nuclearfurnace/cec-wifi-bridge/README.md

# cec-wifi-bridge
A WiFi-enabled HDMI dongle for issuing CEC commands.
