nuclearfurnace/cec-wifi-bridge/projects/enclosure/cec-wifi-bridge-board-rev-a.SLDASM

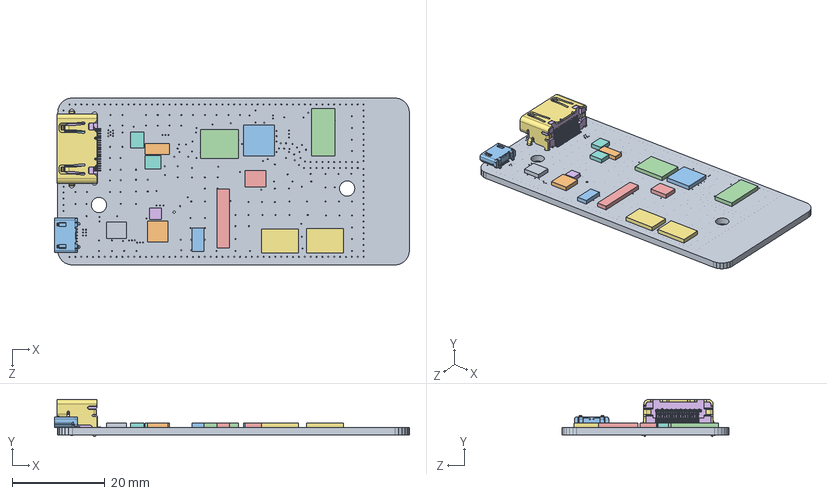
[picture p1: CAD file, 2017-03-05]
projects/enclosure/cec-wifi-bridge-board-rev-a.SLDASM
76.6 x 8.00 x 36.1 mm
cecwifibridgereva
SOD123_1N4148
1X02_J2_1X02
2X04_DEBUG
1X05_PROGRAM
COILCRAFTXPL2010_2_2UH
ALPSSKQG_RESET x 2
SC70_MMBT3904 x 2
5SOT23_MCP73831_2_OT
SPVSONN10DRC_TPS61200DRC
ESP8266EX_ESP8266EX
SOIC8_SPIFLASHSOIC8
EPSONTSX3225_26MHZ
10029451_001_ASM
10029452-001_FLAT
10029452-001_FLAT_1
10029452-001_FLAT_2
10029452-001_FLAT_3
10029452-001_FLAT_4
10029452-001_FLAT_5
10029452-001_FLAT_6
10029452-001_FLAT_7
10029452-001_FLAT_8
10029452-001_FLAT_9
10029452-002_FLAT
10029452-002_FLAT_1
10029452-002_FLAT_2
10029452-002_FLAT_3
10029452-002_FLAT_4
10029452-002_FLAT_5
10029452-002_FLAT_6
10029452-002_FLAT_7
10029452-002_FLAT_8
DX4R005H
