nuclearfurnace/cec-wifi-bridge/projects/enclosure/enclosure-top.sldprt

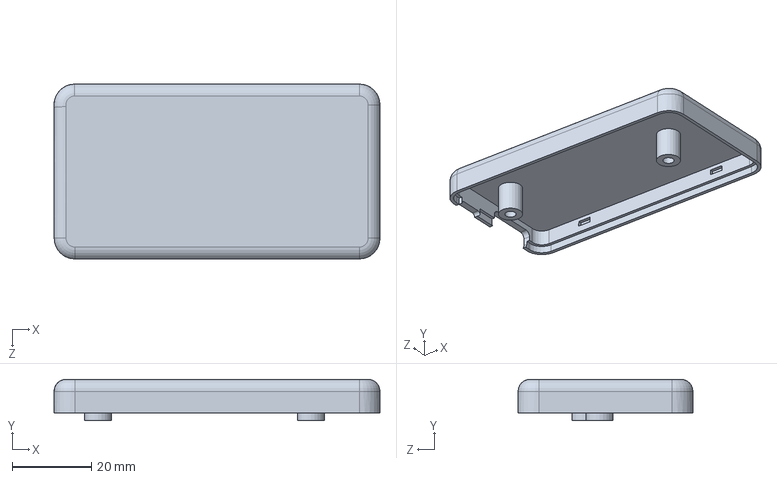
[picture p3: CAD file, 2017-03-05]
projects/enclosure/enclosure-top.sldprt
82.0 x 10.4 x 44.0 mm
