nuclearfurnace/cec-wifi-bridge/projects/enclosure/enclosure-bottom.sldprt

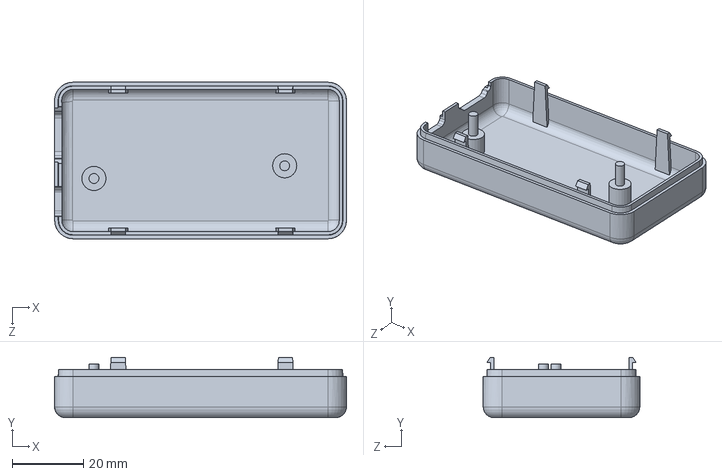
[picture p4: CAD file, 2017-03-05]
projects/enclosure/enclosure-bottom.sldprt
82.0 x 16.9 x 44.0 mm
