nuclearfurnace/cec-wifi-bridge/projects/enclosure/components/DX4R005H.SLDPRT

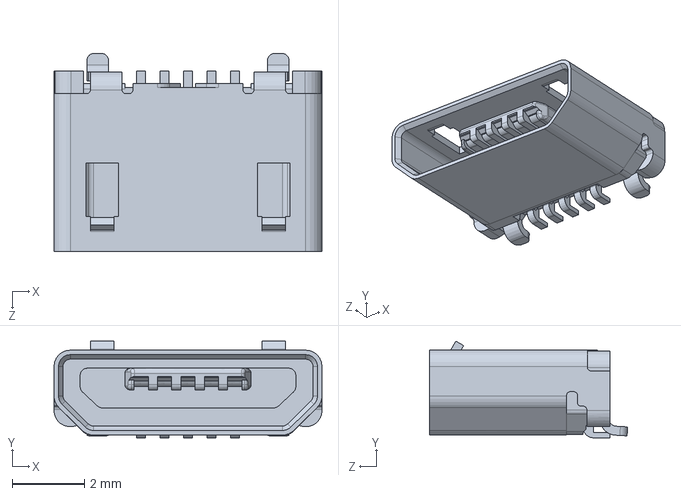
[picture p5: CAD file, 2017-03-05]
projects/enclosure/components/DX4R005H.SLDPRT
7.42 x 2.68 x 5.49 mm
