nuclearfurnace/cec-wifi-bridge/projects/enclosure/components/10029449-001LF.SLDASM

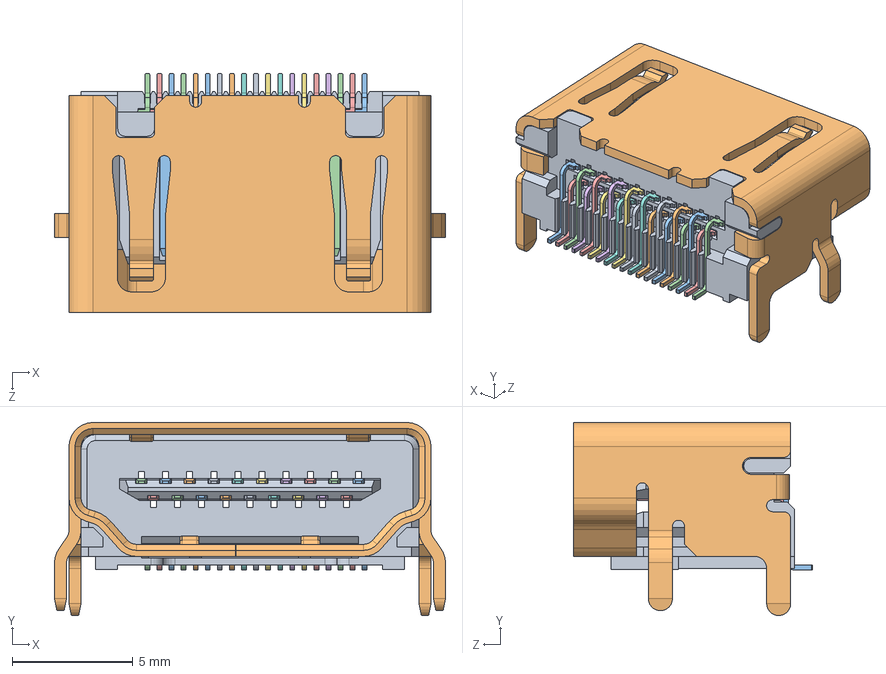
[picture p6: CAD file, 2017-03-05]
projects/enclosure/components/10029449-001LF.SLDASM
16.2 x 8.00 x 9.90 mm
10029451_001_ASM
10029452-001_FLAT
10029452-001_FLAT_1
10029452-001_FLAT_2
10029452-001_FLAT_3
10029452-001_FLAT_4
10029452-001_FLAT_5
10029452-001_FLAT_6
10029452-001_FLAT_7
10029452-001_FLAT_8
10029452-001_FLAT_9
10029452-002_FLAT
10029452-002_FLAT_1
10029452-002_FLAT_2
10029452-002_FLAT_3
10029452-002_FLAT_4
10029452-002_FLAT_5
10029452-002_FLAT_6
10029452-002_FLAT_7
10029452-002_FLAT_8
