nuclearfurnace/cec-wifi-bridge/(list of files, cad)

Other CAD files:
projects/enclosure/components/10029451_001_ASM.sldprt
projects/enclosure/components/10029452-001_FLAT_5.sldprt
projects/enclosure/components/10029452-002_FLAT_7.sldprt
projects/enclosure/components/10029452-001_FLAT_9.sldprt
projects/enclosure/components/10029452-002_FLAT.sldprt
projects/enclosure/components/10029452-001_FLAT.sldprt
projects/enclosure/components/10029452-001_FLAT_2.sldprt
projects/enclosure/components/10029452-002_FLAT_3.sldprt
projects/enclosure/components/10029452-001_FLAT_3.sldprt
projects/enclosure/components/10029452-002_FLAT_8.sldprt
projects/enclosure/components/10029452-002_FLAT_5.sldprt
projects/enclosure/components/10029452-002_FLAT_1.sldprt
projects/enclosure/3d/enclosure-bottom.STL
projects/enclosure/3d/enclosure-top.STL
projects/enclosure/components/10029450.sldprt
projects/enclosure/components/10029452-001_FLAT_1.sldprt
projects/enclosure/components/10029452-001_FLAT_4.sldprt
projects/enclosure/components/10029452-001_FLAT_6.sldprt
projects/enclosure/components/10029452-001_FLAT_7.sldprt
projects/enclosure/components/10029452-001_FLAT_8.sldprt
projects/enclosure/components/10029452-002_FLAT_2.sldprt
projects/enclosure/components/10029452-002_FLAT_4.sldprt
projects/enclosure/components/10029452-002_FLAT_6.sldprt
projects/enclosure/enclosure.SLDPRT
