nuclearfurnace/cec-wifi-bridge/projects/cec-wifi-bridge-rev-a/cec-wifi-bridge-rev-a.brd

## EAGLE design projects/cec-wifi-bridge-rev-a/cec-wifi-bridge-rev-a.brd (2017-03-27)

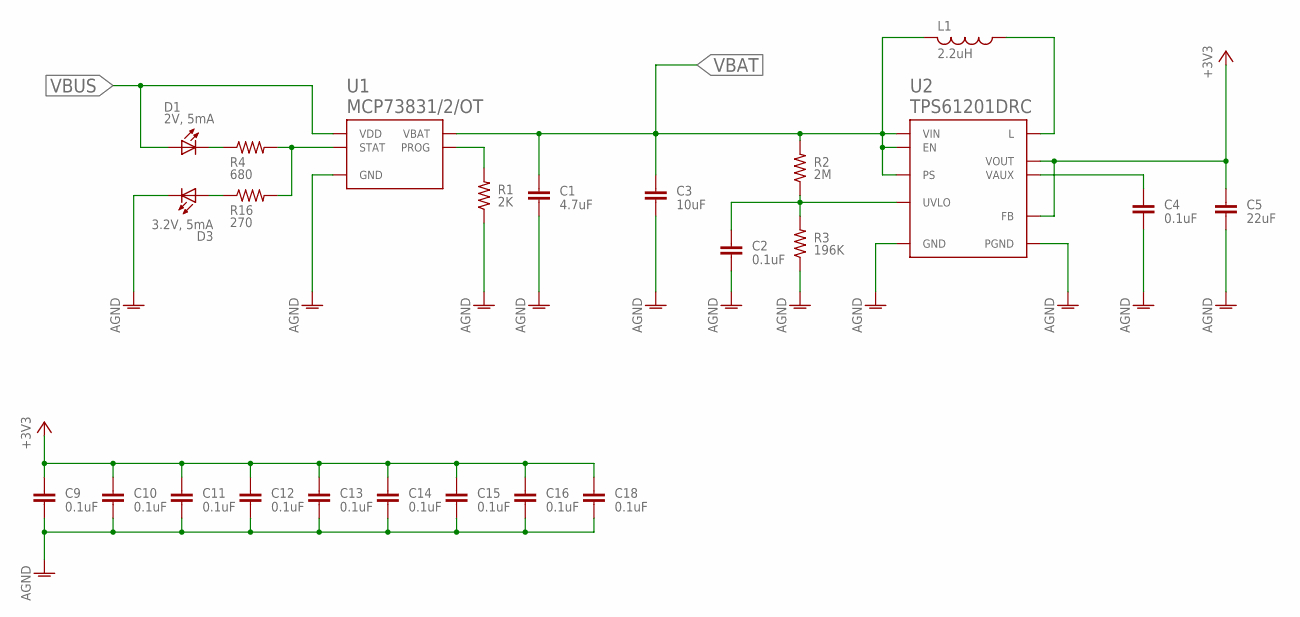
[picture p7: schematic cec-wifi-bridge-rev-a.sch, sheet 1]

Parts:
C1: 4.7uF; C0603
C2, C4, C9, C10, C11, C12, C13, C14, C15, C16, C18: 0.1uF; C0402
C3: 10uF; C0805
C5: 22uF; C0805
D1: 2V, 5mA; DIALIGHT-0603
D3: 3.2V, 5mA; DIALIGHT-0603
L1: 2.2uH; COILCRAFT-XPL2010
R1: 2K; R0402
R2: 2M; R0402
R3: 196K; R0402
R4: 680; R0603
R16: 270; R0603
U1: MCP73831/2/OT; 5-SOT23
U2: TPS61201DRC; S-PVSON-N10-DRC

Connections:
+3V3: C5.1, C9.1, C10.1, C11.1, C12.1, C13.1, C14.1, C15.1, C16.1, C18.1, U2.P$2 (VOUT), U2.P$10 (FB); also elsewhere on the board
AGND: C1.2, C2.2, C3.2, C4.2, C5.2, C9.2, C10.2, C11.2, C12.2, C13.2, C14.2, C15.2, C16.2, C18.2, D3.2 (C), R1.1, R3.1, U1.2 (GND), U2.GND-VIA-1 (PGND), U2.GND-VIA-2 (PGND), U2.GND-VIA-3 (PGND), U2.GND-VIA-4 (PGND), U2.GND-VIA-5 (PGND), U2.P$4 (PGND), U2.P$9 (GND), U2.THERMAL (PGND), U2.THERMAL1 (PGND), U2.THERMAL2 (PGND), U2.THERMAL3 (PGND), U2.THERMAL4 (PGND); also elsewhere on the board
unnamed: C4.1, U2.P$1 (VAUX)
unnamed: R1.2, U1.5 (PROG)
unnamed: D3.1 (A), R16.1
unnamed: C2.1, R2.1, R3.2, U2.P$7 (UVLO)
unnamed: R4.2, R16.2, U1.1 (STAT)
unnamed: D1.2 (C), R4.1
unnamed: L1.P$1 (1), U2.P$3 (L)
VBAT: C1.1, C3.1, L1.P$2 (2), R2.2, U1.3 (VBAT), U2.P$5 (VIN), U2.P$6 (EN), U2.P$8 (PS); also elsewhere on the board
VBUS: D1.1 (A), U1.4 (VDD); also elsewhere on the board

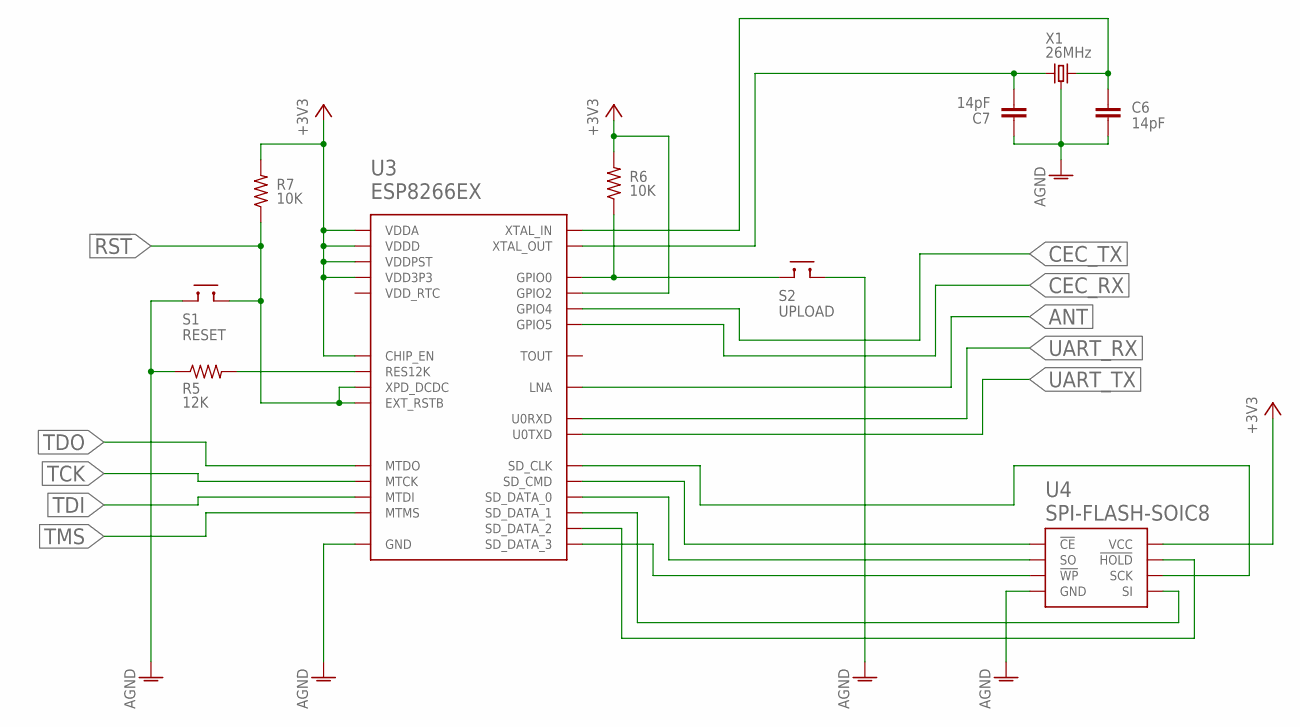
[picture p8: schematic cec-wifi-bridge-rev-a.sch, sheet 2]

Parts:
C6, C7: 14pF; C0402
R5: 12K; R0402
R6, R7: 10K; R0402
S1: RESET; ALPS-SKQG
S2: UPLOAD; ALPS-SKQG
U3: ESP8266EX
U4: SPI-FLASH-SOIC8; SOIC-8
X1: 26MHz; EPSON-TSX-3225

Connections:
!RST: R7.1, S1.P$3, S1.P$4, U3.EXT_RSTB, U3.XPD_DCDC; also elsewhere on the board
+3V3: R6.2, R7.2, U3.CHIP_EN, U3.GPIO2, U3.VDD3P3, U3.VDD3P3$2 (VDD3P3), U3.VDDA, U3.VDDA$2 (VDDA), U3.VDDD, U3.VDDPST, U3.VDDPST$2 (VDDPST), U4.P$8 (VCC); also elsewhere on the board
AGND: C6.2, C7.1, R5.1, S1.P$1, S1.P$2, S2.P$3, S2.P$4, U3.GND, U3.P$1 (GND), U3.P$2 (GND), U3.P$3 (GND), U3.P$4 (GND), U3.P$5 (GND), U3.P$6 (GND), U3.P$7 (GND), U3.P$8 (GND), U3.P$9 (GND), U4.P$4 (GND), X1.P$2 (GND), X1.P$4 (GND); also elsewhere on the board
ANT: U3.LNA; also elsewhere on the board
CEC_RX: U3.GPOIO5 (GPIO5); also elsewhere on the board
CEC_TX: U3.GPIO4; also elsewhere on the board
FLASH_BOOT: R6.1, S2.P$1, S2.P$2, U3.GPIO0
unnamed: R5.2, U3.RES12K
unnamed: C6.1, U3.XTAL_IN, X1.P$3 (2)
unnamed: C7.2, U3.XTAL_OUT, X1.P$1 (1)
unnamed: U3.SD_CLK, U4.P$6 (SCK)
unnamed: U3.SD_CMD, U4.P$1 (!CE)
unnamed: U3.SD_DATA_1, U4.P$5 (SI)
unnamed: U3.SD_DATA_0, U4.P$2 (SO)
unnamed: U3.SD_DATA_3, U4.P$3 (!WP)
unnamed: U3.SD_DATA_2, U4.P$7 (!HOLD)
TCK: U3.MTCK; also elsewhere on the board
TDI: U3.MTDI; also elsewhere on the board
TDO: U3.MTDO; also elsewhere on the board
TMS: U3.MTMS; also elsewhere on the board
UART_RX: U3.U0RXD; also elsewhere on the board
UART_TX: U3.U0TXD; also elsewhere on the board

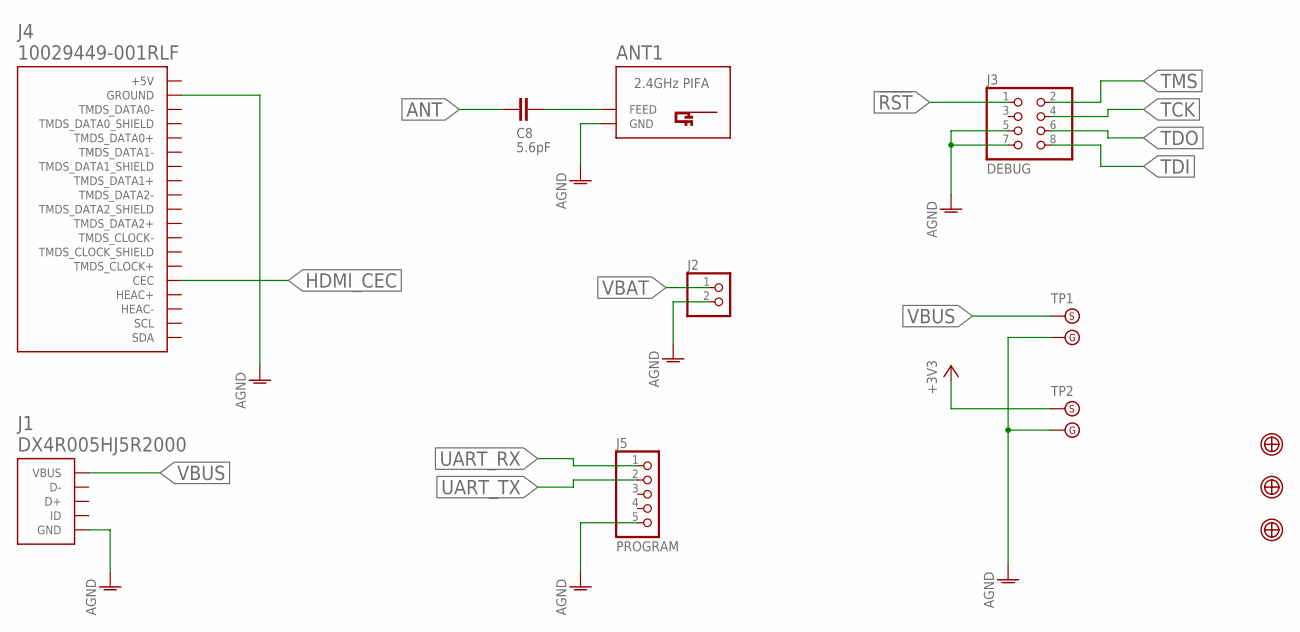
[picture p9: schematic cec-wifi-bridge-rev-a.sch, sheet 3]

Parts:
ANT1: INVERTED_F_ANTENNA+0; DN007+0
C8: 5.6pF; C0402
J1: DX4R005HJ5R2000
J2: PINHD-1X2; 1X02
J3: DEBUG; 2X04
J4: 10029449-001RLF; 10029449
J5: PROGRAM; 1X05
TP1, TP2: TESTPOINT-WITH-GND; TESTPOINT-1.5-WITH-GND
U$1, U$2, U$3: FIDUCIAL-1MM; FIDUCIAL_1MM

Connections:
!RST: J3.1; also elsewhere on the board
+3V3: TP2.S; also elsewhere on the board
AGND: ANT1.GND, ANT1.GND@1 (GND), J1.5 (GND), J1.CASE_1 (GND), J1.CASE_2 (GND), J1.CASE_3 (GND), J1.CASE_4 (GND), J2.2, J3.5, J3.7, J4.P$17 (GROUND), J5.5, TP1.G, TP2.G; also elsewhere on the board
ANT: C8.1; also elsewhere on the board
HDMI_CEC: J4.P$13 (CEC); also elsewhere on the board
unnamed: ANT1.FEED, C8.2
TCK: J3.4; also elsewhere on the board
TDI: J3.8; also elsewhere on the board
TDO: J3.6; also elsewhere on the board
TMS: J3.2; also elsewhere on the board
UART_RX: J5.1; also elsewhere on the board
UART_TX: J5.2; also elsewhere on the board
VBAT: J2.1; also elsewhere on the board
VBUS: J1.1 (VBUS), TP1.S; also elsewhere on the board

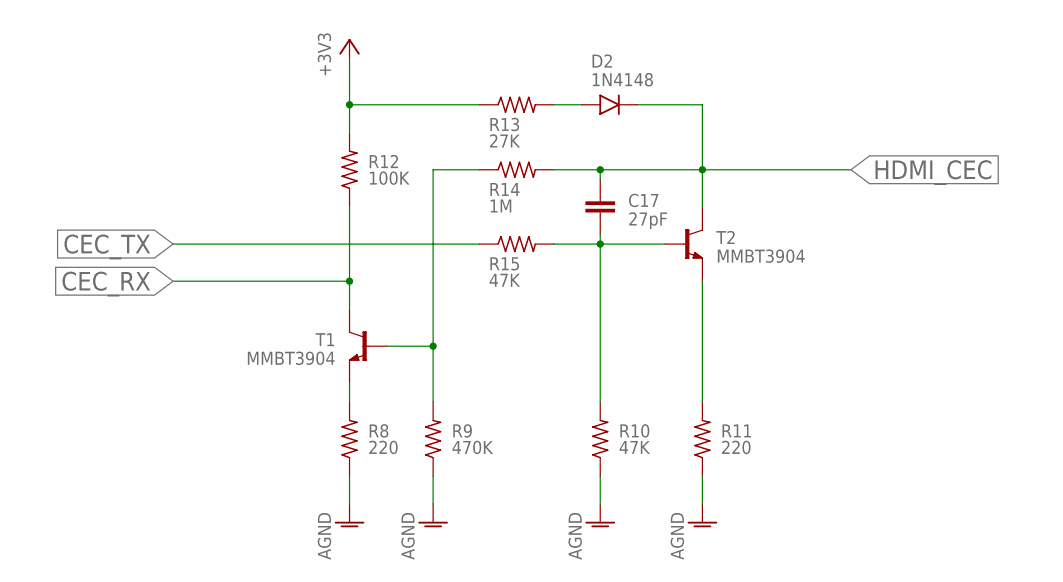
[picture p10: schematic cec-wifi-bridge-rev-a.sch, sheet 4]

Parts:
C17: 27pF; C0402
D2: 1N4148; SOD123
R8, R11: 220; R0402
R9: 470K; R0402
R10, R15: 47K; R0402
R12: 100K; R0402
R13: 27K; R0402
R14: 1M; R0402
T1, T2: MMBT3904; SOT-23

Connections:
+3V3: R12.2, R13.1; also elsewhere on the board
AGND: R8.1, R9.1, R10.1, R11.1; also elsewhere on the board
CEC_RX: R12.1, T1.P$3 (C); also elsewhere on the board
CEC_TX: R15.1; also elsewhere on the board
HDMI_CEC: C17.1, D2.C, R14.2, T2.P$3 (C); also elsewhere on the board
unnamed: C17.2, R10.2, R15.2, T2.P$1 (B)
unnamed: R8.2, T1.P$2 (E)
unnamed: R9.2, R14.1, T1.P$1 (B)
unnamed: D2.A, R13.2
unnamed: R11.2, T2.P$2 (E)

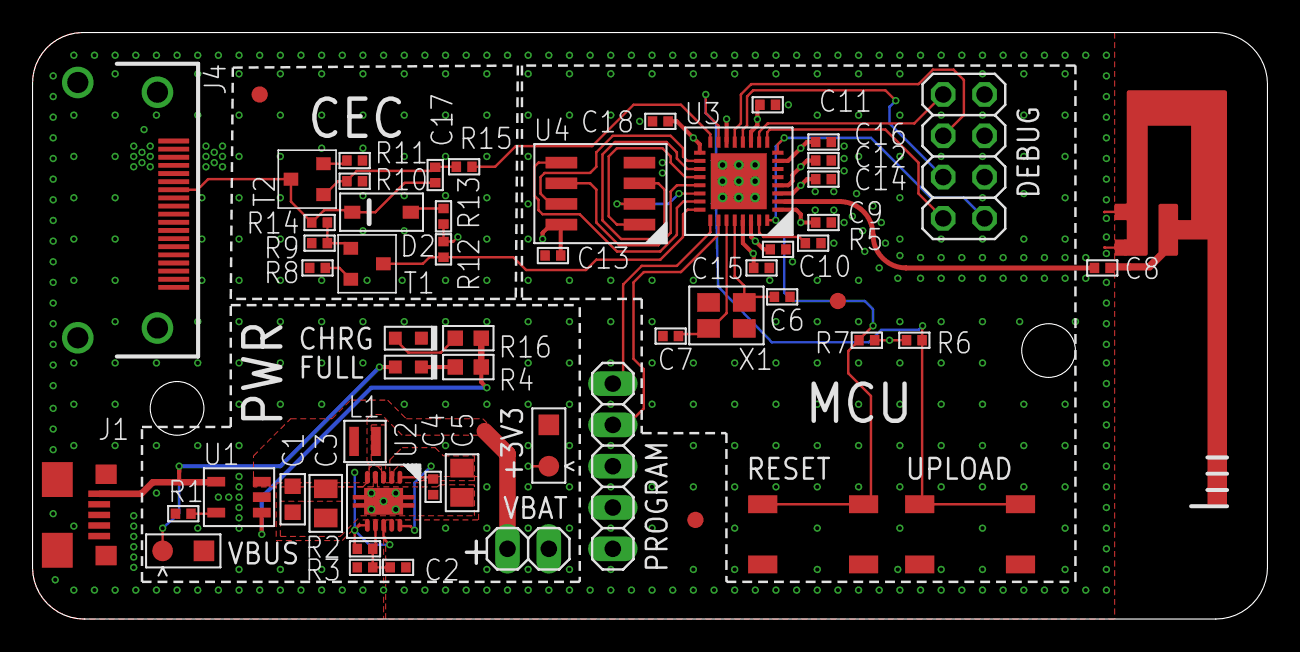
[picture p11: board cec-wifi-bridge-rev-a.brd from above]

Board: 4 copper layers, 75.9 x 36.1 mm, 58 parts (0 on the bottom side), 38 nets.
