nuclearfurnace/cec-wifi-bridge/(commit log)

2017-01-21 Initial commit of the rev A design.
    Right now we just have the power supply and battery charging section
    done.
    [cec-wifi-bridge-rev-a.brd, cec-wifi-bridge-rev-a.sch]
2017-01-21 Repository streamlining.
    Making this match our other Eagle projects, including directory
    structure and automated tests.
    [cec-wifi-bridge-rev-a.brd, cec-wifi-bridge-rev-a.sch]
2017-01-21 Bad path to schematic.
2017-01-22 Starting to add in the main bits.
    [cec-wifi-bridge-rev-a.brd, cec-wifi-bridge-rev-a.sch]
2017-01-23 Start wiring up the ESP8266.
    [cec-wifi-bridge-rev-a.brd, cec-wifi-bridge-rev-a.sch]
2017-01-26 Lots of tweaks and changes.
    [cec-wifi-bridge-rev-a.brd, cec-wifi-bridge-rev-a.sch]
2017-01-27 Lots of board layout work.
    The board is basically done.
    It has a real shape now, things are laid out. We have fiducials,
    alignment holes, rounded edges, the PCB antenna with the proper
    setbacks, ground plane stitching, we have our logo in place (!), and
    things are generally buttoned up.
    We still need to fill out the BOM entirely, as well as clean up the
    schematic sheets and add proper titles/descriptions, etc.
    Also need to look into bitmap art for open source hardware to start
    throwing on the board. Should probably add the license / attribution
    stuff, as well.
    [cec-wifi-bridge-rev-a.brd, cec-wifi-bridge-rev-a.sch]
2017-01-29 Filled in BOM and super stitched.
    Filled in all of the BOM values. Also stitches the hell out of the
    board. Realllly stitched it. Probably overstitched it.
    [cec-wifi-bridge-rev-a.brd, cec-wifi-bridge-rev-a.sch]
2017-01-31 Add BOM parts and adjust alignment holes.
    Added the remaining two BOM values.
    Adjusted the location of the alignment pin holes so that we can cleanly
    fit the LiPo battery on the underside of the board without it being
    under the PCB antenna and without it being too close to the HDMI
    through-hole pins.
    [cec-wifi-bridge-rev-a.brd, cec-wifi-bridge-rev-a.sch]
2017-02-01 Add LED and more board tweaking.
    Added another LED after realizing that STAT on the battery charger IC is
    actually tri-state -- thanks, Adafruit! This means we can now show when
    the battery is charging and when it's full, wee!
    Also moved bits and pieces around on the board. Spread out the
    stitching vias, moved vias out of the way of the silkscreen, etc etc.
    [cec-wifi-bridge-rev-a.brd, cec-wifi-bridge-rev-a.sch]
2017-02-04 Generating MCAD files and prepping to start the enclosure design.
    [cec-wifi-bridge-rev-a.brd]
2017-02-04 Switch to DX4R005HJ5R2000 for USB connector.
    The other version we were using had no 3D model available from JAE, so I
    found one that did, so we can properly design the enclosure and model it
    all assembled.
    [cec-wifi-bridge-rev-a.brd, cec-wifi-bridge-rev-a.sch]
2017-02-04 Start adding in the MCAD files.
    I did a rough import that got the board into an MCAD state. We have
    both connectors modeled properly, so now we can start to work on a
    design for the enclosure.
    [10029449-001LF.SLDASM, 10029450.sldprt, 10029451_001_ASM.sldprt, 10029452-001_FLAT.sldprt, 10029452-001_FLAT_1.sldprt, 10029452-001_FLAT_2.sldprt, 10029452-001_FLAT_3.sldprt, 10029452-001_FLAT_4.sldprt]
2017-02-06 Created an enclosure for the circuit board.
    I whipped up a simple enclosure for the board in SolidWorks. Some of
    the features:
    - has enough space under the board for the LiPo battery to be nestled
    - locating pins to lock the board in place
    - snap hooks for toolless assembly
    I'm pretty sure we should be able to 3D print this, although the feature
    sizes on the snap hooks is a little small, so I'll have to get a test
    printing and see how it fares.
    [10029449-001LF.SLDASM, 10029450.sldprt, 10029451_001_ASM.sldprt, 10029452-001_FLAT.sldprt, 10029452-001_FLAT_1.sldprt, 10029452-001_FLAT_2.sldprt, 10029452-001_FLAT_3.sldprt, 10029452-001_FLAT_4.sldprt]
2017-02-06 Generate 3D STL versions of the top and bottom pieces.
    Just turned off some planes from view and then generated STL versions of
    the top and bottom pieces so we can get this printed.
    [enclosure-bottom.STL, enclosure-bottom.sldprt, enclosure-top.STL, enclosure-top.sldprt, enclosure.SLDASM]
2017-02-06 Add part number for ESP8266.
    [cec-wifi-bridge-rev-a.brd, cec-wifi-bridge-rev-a.sch]
2017-02-07 More sane stitching.
    The stitching before was haphazard, ugly, overkill, and generally
    wasteful. I did a more sane and uniform stitching of ground.
    Looks better, and I'm guessing things will function just the same.
    [cec-wifi-bridge-rev-a.brd]
2017-02-09 Fixing up the alignment of the USB port with the actuality of the enclosure.
    [10029449-001LF.SLDASM, 10029450.sldprt, 10029451_001_ASM.sldprt, 10029452-001_FLAT.sldprt, 10029452-001_FLAT_1.sldprt, 10029452-001_FLAT_2.sldprt, 10029452-001_FLAT_3.sldprt, 10029452-001_FLAT_4.sldprt]
2017-02-09 Add testpoints for the power rails.
    [cec-wifi-bridge-rev-a.brd, cec-wifi-bridge-rev-a.sch]
2017-02-09 Small stitching tweaks. Last tweaks, I promise!
    [cec-wifi-bridge-rev-a.brd]
2017-02-13 Final layout tweaks before locking rev A.
    We've given the TPS61200 its own power ground, hopefully quashing as
    much noise as possible off the main ground, keeping RF performance high.
    I lied, and went back to adjust the stitching. We should have our
    stitching on a 100 mil grid consistently, with a few exceptions to deal
    with component placement.
    Also fixed a bug where we had a decoupling cap on a configuration pin
    instead of a supply pin.
    [cec-wifi-bridge-rev-a.brd, cec-wifi-bridge-rev-a.sch]
2017-02-20 BOM tweaks to account for supply chain issues.
    [cec-wifi-bridge-rev-a.brd, cec-wifi-bridge-rev-a.sch]
2017-03-05 Tweaks t to the enclosure dimensions.
    After getting prototypes made, there were a few design errors that
    needed to be corrected:
    - didn't include any tolerance for the locating pins
    - board was too snug of a fit between snap hooks to easily seat
    - edge fillets were too small and ended up more like chamfers
    - didn't propagate the HDMI connector cut-out to the assembly parts
    The board now has a 1mm clearance around the perimeter except for the
    connector edge. The fillet on the enclosure edges is also 1mm larger
    which should actually provide a more rounded edge.
    The locating pins are also 0.1mm smaller in radius, while the locating
    pin holes are 0.1mm larger in radius. This will make them e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
    [10029449-001LF.SLDASM, 10029450.sldprt, 10029451_001_ASM.sldprt, 10029452-001_FLAT.sldprt, 10029452-001_FLAT_1.sldprt, 10029452-001_FLAT_2.sldprt, 10029452-001_FLAT_3.sldprt, 10029452-001_FLAT_4.sldprt]
2017-03-27 A few fixes after testing the rev A1 boards.
    Just fixing up a fix issues I found while build/testing the rev A1
    boards, namely:
    - using wrong footprint for T1/T2
    - LEDs way too bright; adjusted series resistors
    - used wrong part number for boost converter (ooof!)
    - shoved HDMI connector closer to the edge
    - added outlines to the various sections
    - shuffled around test points and labels
    [cec-wifi-bridge-rev-a.brd, cec-wifi-bridge-rev-a.sch]
